olwal/rnet-adaptive-input/README.md

# R-net Adaptive Input

### Use a wheelchair joystick as a mouse, keyboard or game controller

*A bench experiment, not a mobility product. See the [disclaimer](#disclaimer).*

https://github.com/user-attachments/assets/6f5dde21-41e2-4d8e-a4ac-a26c28fd4ac4

Wheelchair joysticks are robust input devices, but typically connect only to their own wheelchair controller,
over a private analogue interface.

This project uses a small microcontroller between the joystick
and a computer to overcome that limitation. It allows the computer to see the joystick as an ordinary USB peripheral without
software or drivers to install.

**Capabilities**

- **Mouse.** Control a cursor, with an adjustable dead zone and
  response curve so small hand movements stay usable.
- **Keyboard.** Send arrow keys for anything menu- or key-driven, or remap the
  four directions to any letter, digit, or named key at runtime.
- **Game controller.** Emulate a standard USB gamepad, so games, flight and driving
  sims, and RC simulators see it as a normal stick.
- **Integrate with custom software.** Raw and shaped values stream over a serial link
  the whole time, whatever mode it is in.

All of them are available at once. A small command-line tool selects which
interface the stick drives, because these joysticks have no spare button to
switch with; the serial stream runs regardless of the mode.

| Page | Contents |
|---|---|
| [Hardware and pinout](docs/hardware.md) | Identifying the joystick, the verified 9-pin D-sub pinout, supporting measurements, bring-up |
| [Wiring the Teensy](docs/wiring.md) | Divider design for a 3.3 V ADC, pad map, expected readings, known issues |
| [Browser configurator](https://olwal.github.io/rnet-adaptive-input/config.html) | Set modes, tune response and remap keys from Chrome or Edge, no install |
| [Firmware](docs/firmware.md) | The bring-up sketch, the multi-HID build, and the serial protocol |
| [Host tooling](docs/tooling.md) | Build, flash, monitor and tune without installing a toolchain |
| [Marble game](docs/demo-labyrinth.md) | The tilt labyrinth demo: controls, levels, how it is rendered |
| [Single-stick game design](docs/joystick-only-games-brief.md) | Notes on interaction design for one axis pair with no buttons |
| [Builds and releases](docs/releases.md) | The standalone binaries, and how they are built and published |
| [Open questions and roadmap](docs/roadmap.md) | Unresolved items and planned work |

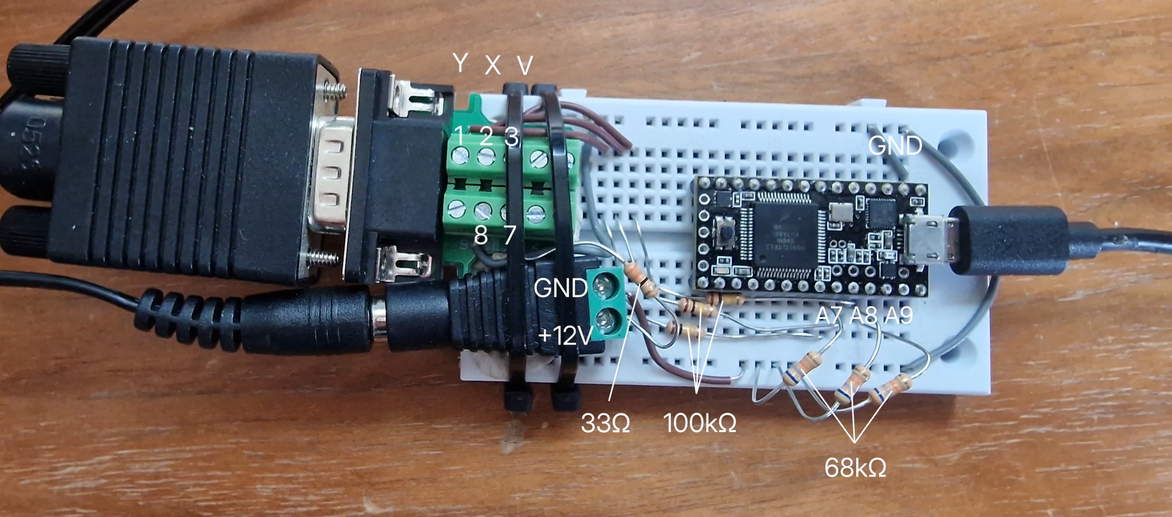
[picture p1: docs/diagram.jpg]
The bench build: R-Net joystick on a D-sub breakout, dividers, and a Teensy 3.0


## Quick start

**Hardware**: a Teensy 3.0, six resistors, a 12 V bench supply, and an R-Net
specialty joystick.

**Software**:
- **Arduino IDE 2.x with Teensyduino.** No separate toolchain install; the
  tooling drives the `arduino-cli` bundled inside the IDE.
- **Python 3.9+** with `pyserial`. The marble game also requires `raylib`, `numpy`
  and `scipy`; `crosshair.py` wants `pygame`.

  ```
  python -m pip install pyserial pygame raylib numpy scipy
  ```

Everything here runs on Windows, macOS and Linux. `rnet` below means `./rnet`
on macOS and Linux, `rnet.cmd` on Windows, or `python tools/rnet.py` anywhere.
Run `rnet doctor` first on a new machine: it reports the toolchain it found,
the serial ports it can see, and which one it would use.

**Prebuilt binaries** for all three platforms are on the
[releases page](../../releases), if you only want to talk to a board someone
else has already flashed. They bundle `rnet`, `scope` and `hid` and need no
Python. Building firmware still needs a clone and the Arduino IDE. See
[builds and releases](docs/releases.md).

### 1. Build and flash

1. Wire the dividers. The circuit, the pad map and the derivation are in
   [wiring](docs/wiring.md). Nothing goes straight to a Teensy pin: the
   joystick swings to 6.8 V and the Teensy is a 3.3 V part that is not 5 V
   tolerant.

2. Flash the multi-HID firmware:

   ```
   rnet flash --hid
   ```

3. The USB descriptor set changes, so the board comes back on a **new COM
   port**. Re-pin it once:

   ```
   rnet config
   ```

It boots **parked**, driving nothing. That is deliberate: a stick that can move
the cursor and type is a device that can do damage to the host if it drifts, so
nothing happens until you ask for it.

If you want it to come up ready to use, say so explicitly and save it to the
board:

```
rnet hid boot mouse
rnet hid save
```

That is also the only way to use it on a host that cannot talk to the serial
port, such as an iPad. See [roadmap](docs/roadmap.md) for what works where.

To check the raw signals instead, flash the bring-up sketch with
`rnet flash` and watch them with `python tools/scope.py`. More in
[firmware](docs/firmware.md).

### 2. Use it

All the interfaces are live at once; you pick which one the stick drives.

**a) As a mouse**

```
rnet hid mode mouse
rnet hid set mousegain 900     # cursor speed, 40 to 3000
```

Velocity mapping, so the stick steers the cursor and lets it stop, rather than
snapping it back to the middle on release. The switch on the 3.5 mm jack is
left-click.

**b) As a keyboard**

```
rnet hid mode keyboard
rnet hid keys wasd             # or arrows (default), ijkl, media, playback
rnet hid keys up space         # or remap one direction at a time
```

Separate press and release thresholds, so it does not chatter at the boundary.
Any letter, digit or named key works: `space`, `enter`, `pageup`, `volup` and
so on; `rnet hid keys` shows the current mapping.

**c) Playing the marble game**

```
rnet hid mode park             # so it is not also moving the cursor
rnet demo labyrinth
```

Tilt a wooden board to roll a marble to the green cup. The game reads the serial
stream directly, which runs in every mode, so **park it first**, otherwise the
stick plays the game and drives your mouse at the same time. Only one program
can hold the port, so set the mode before launching the game.

**No terminal?** Open the [browser configurator](https://olwal.github.io/rnet-adaptive-input/config.html) in Chrome or Edge,
click Connect, and set everything from sliders: mode, response curves, key
mapping, and a resting-drift check. Press *Save to device* and it persists on
the board, so it applies on hosts the page cannot reach - an iPad claims the
serial port before any app can use it. The same page can also listen for
spoken commands - "left click", "right click", "middle click", or a mode
name - and send them over the connection it already has open, for anyone who
would rather speak a click than push the stick's own switch. Clicking works
over serial in any mode, not only mouse mode, so a spoken "left click" still
lands even while the stick is driving the keyboard or a game.

**Everything else:** `rnet hid` on its own opens an interactive session
for live tuning, and `rnet hid --help` lists every mode and setting with
its range. Gamepad mode is `rnet hid mode gamepad`, and it is DirectInput
rather than XInput; see [firmware](docs/firmware.md) if a game cannot see it.

Details: [firmware and the serial protocol](docs/firmware.md) ·
[host tooling](docs/tooling.md) · [the marble game](docs/demo-labyrinth.md)

Mouse and keyboard modes work on **iPadOS and iOS** too, over USB. Gamepad mode
does not, and nothing on the tablet can send commands, so set the mode with
`boot` and `save` from a computer first. Details in
[roadmap](docs/roadmap.md).

## References

- **CustomSID by Bob Paradiso.** A custom SID emulator, driving an Omni from
  alternative inputs. This project does the inverse, reading the real joystick,
  but the connector pinout is the same and the KiCad schematic was used for
  pin-by-pin verification.
  [Repository](https://github.com/bobparadiso/CustomSID) ·
  [write-up](https://bobparadiso.com/2018/10/09/custom-proportional-power-wheelchair-drive-controls/),
  including voltage specifications (Vref at 50 % of 12 V, ±1.2 V deflection).
- **PG Drives R-Net Omni Technical Manual**, document `SK78813-07`. The SID port
  section documents the 9-way D-type connector. Not redistributed here, as it is
  PG Drives / Curtiss-Wright copyright.
- **Teensy 3.0 pinout cards.** <https://www.pjrc.com/teensy/pinout.html>
  (`card5a` and `card5b`).

## Disclaimer

A personal experiment with a salvaged joystick on a bench supply, published
as-is and used entirely at your own risk.

**This is not intended for use with a real wheelchair or any live mobility
system.** It is not a product, it is not certified, and it has not been tested
for safety. Nothing here should be connected to equipment anyone depends on.

No warranty of any kind. See [LICENSE](LICENSE).

## License

MIT. See [LICENSE](LICENSE).
