olwal/rnet-adaptive-input/docs/social-preview.jpg

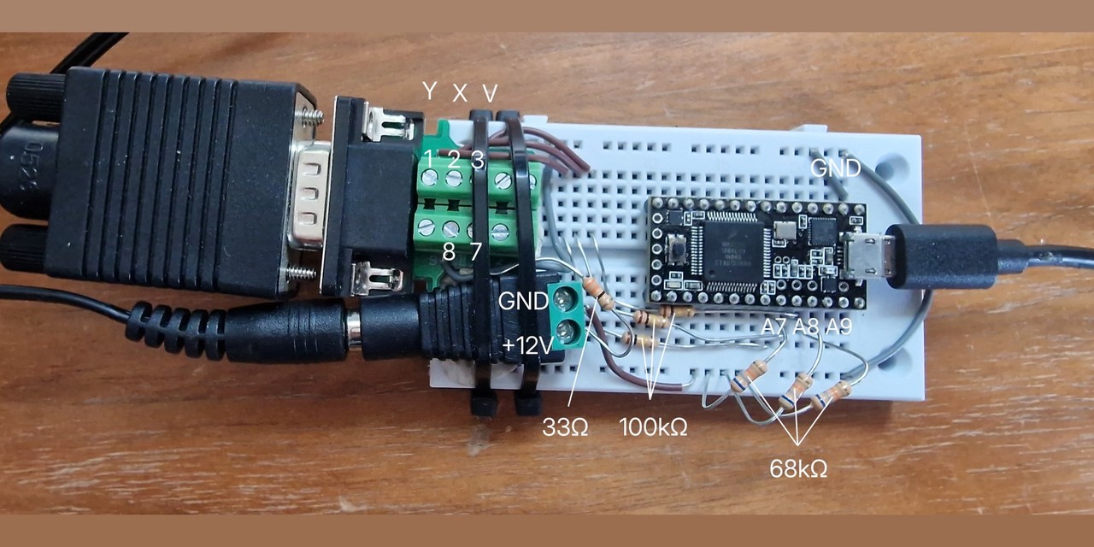
docs/social-preview.jpg
