olwal/rnet-adaptive-input/(commit log)

2026-08-09 Initial commit: R-Net joystick interface, tooling and tilt labyrinth
    Reads a Permobil R-Net specialty joystick (Omni-compatible SID) from a
    Teensy 3.0 and turns it into a proportional, button-free input device.
    Hardware
    - Pinout verified on real hardware against the PG Drives manual, Bob
    Paradiso's CustomSID schematic, and direct DMM measurement.
    - 100k/68k dividers sized for the Teensy's 3.3 V ADC.
    - Bring-up firmware plus a multi-HID build (gamepad / mouse / keyboard).
    Tooling
    - rnet.ps1: build, flash, monitor and launch, wrapping the arduino-cli
    bundled inside Arduino IDE 2.x so there is no separate toolchain.
    - scope.py: ASCII scope with crosstalk analysis.
    - crosshair.py: shaping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
2026-08-09 Split the README into docs pages
    The README had grown to 617 lines and buried the thing the repo is actually
    for. It is now a 90-line front page - what this is, the disclaimer, status,
    quick start, and an index - with the detail moved to docs/:
    hardware.md pinout, measurements, bring-up
    wiring.md divider design, pad map, field notes
    firmware.md bring-up sketch, multi-HID build, serial protocol
    tooling.md build/flash/monitor, scope, shaping harness, display
    demo-labyrinth.md the demo, moved off the front page - it is a worked
    example, not the point of the repo
    roadmap.md open hardware questions, plus cross-platform work
    Cross-platform is now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
2026-08-09 Use the build photo in the docs; drop the PJRC pinout cards
    The annotated bench photo says more than the ASCII schematic did, so it now
    opens the README and the wiring page, with a caption tying the labels to the
    pin numbers.
    The Teensy pinout cards are PJRC's, and the docs already link to them, so
    they are out of the repo and gitignored rather than redistributed.
2026-08-09 Neutral tone, no em-dashes, JPEG screenshots, schematic on the front page
    Prose pass across the README and all docs pages: removed editorial and
    promotional phrasing, and replaced all 90 em-dashes with ordinary punctuation.
    Headings that editorialised ("Five decisions worth knowing", "Lessons, each of
    which cost a debugging round") are now plain descriptive headings.
    demo-labyrinth.md rewritten. It describes what the demo is and how it works
    rather than arguing for it, and shows four levels inline.
    Screenshots converted from PNG to JPEG and moved into docs/: 2.9 MB down to
    406 KB for the same four images. shots/ is gone.
    The ASCII schematic is back on the front page alongside the build ph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
2026-08-09 Lead with what it does; add the manufacturer pin table and social preview
2026-08-09 Restructure quick start: flash HID by default, then how to use each mode; drop the duplicated circuit
2026-08-10 Add runtime key remapping for keyboard mode; correct the multi-interface wording
    [hid.py, r-net_hid.ino]
2026-08-10 Cross-platform tooling, shared port discovery, EEPROM persistence
    Port the build wrapper off PowerShell
    ------------------------------------
    tools/rnet.py replaces tools/rnet.ps1. Same command surface, runs on Windows,
    macOS and Linux. It locates the arduino-cli bundled inside Arduino IDE 2.x per
    platform (Application bundle on macOS, Program Files or LOCALAPPDATA on
    Windows, ~/.arduinoIDE or /opt on Linux) and falls back to one on PATH, with
    ARDUINO_CLI to override. Thin `rnet` and `rnet.cmd` shims call it.
    `doctor` now reports the platform, the Python and CLI in use, whether pyserial
    is present, every visible serial port and which one would be chosen, so a new
    machine can be diagnosed in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
    [crosshair.py, engine.py, hid.py, r-net_hid.ino, rnet.py, rnetport.py, scope.py]
2026-08-10 Make the tools packageable, and fail loudly on the wrong serial port
    rnet.py shelled out with sys.executable, which in a PyInstaller build is the
    bundled executable rather than a Python interpreter, and the .py files are not
    on disk at all. A frozen build now imports the sibling tool and calls its
    main() in-process. Unfrozen behaviour is unchanged, since a subprocess keeps
    the tools isolated.
    Port discovery falls back to the only serial device present when no PJRC board
    is attached. That is usually helpful but it will happily open an unrelated
    board: with an ESP32 plugged in and the Teensy unplugged, scope.py opened the
    ESP32 and blocked forever waiting for telemetry.
    It now reports which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
    [rnet.py, scope.py]
2026-08-10 Package rnet as a standalone binary, and build one per platform in CI
    packaging/rnet.spec produces a single 8 MB executable containing rnet, scope,
    hid and pyserial, so the tools can be used without installing Python. The
    marble game is excluded: raylib, numpy and scipy would take the download past
    150 MB for something most people will not run.
    Two things had to be fixed before this worked at all.
    A frozen build cannot use __file__ to locate anything. PyInstaller unpacks to
    a temporary directory, so the project root resolved to %TEMP% and board.json
    would have been written there and lost between runs. The project root is now
    discovered by walking up from the working directory, and when the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
    [rnet.py, rnetport.py]
2026-08-11 Document the build and release process on its own page
    The packaging detail was buried in tooling.md, and the README said nothing
    about downloads at all, so someone who just wants to talk to a board had no
    route that did not start with cloning the repo.
    docs/releases.md covers what a release contains, how the binary behaves
    differently inside and outside a checkout, how to build locally, the exact
    steps to publish, and a checklist for verifying a build on a platform you do
    not own. tooling.md keeps a pointer instead of a copy.
    Adds `rnet --version`, which reports the version, whether the build is packaged
    or from source, and the platform. That is the first line of a useful bug report
    from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
    [rnet.py]
2026-08-13 Fix the Intel macOS runner, and stop a missing runner costing a day
    The macos-13 job never ran. That image was retired on 4 December 2025, and a
    job requesting a runner that will never appear does not fail fast: it queues
    for 24 hours and then times out. macos-15-intel replaces it and is the last
    x86_64 macOS image GitHub will offer, available until August 2027.
    Every build job now carries timeout-minutes: 30, so the next time a runner
    label goes away it is a quick failure instead of a day of queueing.
    Bumps the actions to current majors, which clears the Node 20 deprecation
    warnings on all four jobs: checkout v7, setup-python v7, upload-artifact v7,
    download-artifact v8, action-gh-release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
2026-08-19 Make voice control debuggable: log to console, surface network errors
    Speech recognition errors were either swallowed silently or retried forever,
    so a broken mic pipeline and a working one looked identical. Mirrors all log
    lines to the browser console, confirms the recognizer actually started, and
    gives up with an explanation after repeated "network" errors instead of
    looping. Also stops gating the listen button on having a board connected,
    since recognition is worth testing on its own.
